samuelpratt/EnvironmentMonitor/(list of files, drawings)

Other design files:
ArduinoSensor/Breadboard.fzz
