samuelpratt/EnvironmentMonitor/(commit log)

2020-05-17 Got sensor and screen working.
2020-05-17 Removed button. Added HTTP status code to display. Reformatted display.
2020-05-17 Sorted out buttons etc. Added breadboad design.
    [Breadboard.fzz]
2020-05-18 Fiexed some issues.
    [Breadboard.fzz]
2020-05-18 Got new BME280 sensor board working
2020-05-18 Added comment regarding B280 I2C address.
2020-05-18 Sorted out buttons etc.
2020-05-18 Fixed LCD init params.
    [ArduinoSensor.ino]
2020-05-18 Put labels on board.
    [Breadboard.fzz]
2020-05-18 Moved Arduino so that you can access the Serial port.
    [Breadboard.fzz]
2020-05-24 Re-added lost comment re i2c address.
2020-06-16 Added images of built board.
